Matlock42/SensoryBridge/extras/OSHW/PCB/SENSORY_BRIDGE_kicad6/SENSORY_BRIDGE_BOM.xlsx

Index | Quantity | Part Number | Manufacturer Part Number | Description | Customer Reference | Available | Backorder | Unit Price | Extended Price USD
1 | 1 | 796949-4-ND | 796949-4 | TERM BLK 4P SIDE ENT 5.08MM PCB | J2 | 1 | 0 | 2.93 | 2.93
2 | 1 | 1965-ESP32-S2-MINI-1-N4R2CT-ND | ESP32-S2-MINI-1-N4R2 | SMD MOD ESP32-S2FN4R2 PCB ANT | IC1 | 1 | 0 | 2.32 | 2.32
3 | 1 | 497-13420-1-ND | ECMF02-4CMX8 | CMC 2LN SMD ESD | U3 | 1 | 0 | 0.87 | 0.87
4 | 1 | AP7361-33E-13DICT-ND | AP7361-33E-13 | IC REG LINEAR 3.3V 1A SOT223 | U2 | 0 | 1 | 0.54 | 0.54
5 | 2 | CKN9104CT-ND | PTS525SM15SMTR2 LFS | SWITCH TACTILE SPST-NO 0.02A 15V | SW3 | 2 | 0 | 0.65 | 1.30
6 | 1 | 423-1405-1-ND | SPH0645LM4H-B | CRAWFORD MIC DGT I2S BOTTOM PORT | U1 | 1 | 0 | 3.18 | 3.18
7 | 1 | 2073-USB4110-GF-A-1-ND | USB4110-GF-A | CONN RCP USB2.0 TYP C 24P SMD RA | J1 | 1 | 0 | 1.35 | 1.35
8 | 3 | 3386P-103TLF-ND | 3386P-1-103TLF | TRIMMER 10K OHM 0.5W PC PIN TOP | R1, R2, R3 | 3 | 0 | 2.5 | 7.50
9 | 1 | S7109-ND | PPPC062LFBN-RC | CONN HDR 12POS 0.1 GOLD PCB | JP1 | 1 | 0 | 0.82 | 0.82
10 | 1 | BL-BGX3V1-ND | BL-BGX3V1 | LED GREEN CLEAR 3M T/H | LED2 | 1 | 0 | 0.27 | 0.27
11 | 2 | 732-5014-ND | 151033YS03000 | LED YELLOW CLEAR 3MM ROUND T/H | LED1, LED3 | 2 | 0 | 0.18 | 0.36
12 | 1 | RMCF0805JT30R0CT-ND | RMCF0805JT30R0 | RES 30 OHM 5% 1/8W 0805 | R5 | 1 | 0 | 0.1 | 0.10
13 | 3 | 738-RMCF0805FT66R5CT-ND | RMCF0805FT66R5 | RES 66.5 OHM 1% 1/8W 0805 | R4, R6 | 3 | 0 | 0.1 | 0.30
14 | 1 | YAG3758CT-ND | AC0805JR-0710KL | RES SMD 10K OHM 5% 1/8W 0805 | R7 | 1 | 0 | 0.1 | 0.10
15 | 2 | YAG3744CT-ND | AC0805FR-075K1L | RES SMD 5.1K OHM 1% 1/8W 0805 | R9 | 2 | 0 | 0.1 | 0.20
16 | 4 | 1276-1099-1-ND | CL21B104KACNNNC | CAP CER 0.1UF 25V X7R 0805 | C5 | 4 | 0 | 0.1 | 0.40
17 | 3 | 1276-1066-1-ND | CL21B105KAFNNNE | CAP CER 1UF 25V X7R 0805 | C1 | 3 | 0 | 0.1 | 0.30
18 | 2 | 399-C0805C200J5HAC7800CT-ND | C0805C200J5HAC7800 | CAP CER 20PF 50V X8R 0805 | C7 | 2 | 0 | 0.1 | 0.20
19 | 1 | 1276-6460-1-ND | CL21A226MQQNNNG | CAP CER 22UF 6.3V X5R 0805 | C4 | 1 | 0 | 0.13 | 0.13
20 | 1 | 1276-1244-1-ND | CL21A475KAQNNNE | CAP CER 4.7UF 25V X5R 0805 | C2 | 1 | 0 | 0.1 | 0.10
21 | 1 | AZ1117IH-3.3TRG1DICT-ND | AZ1117IH-3.3TRG1 | IC REG LINEAR 3.3V 1A SOT223 | U2 Alt (chng pins) | 1 | 0 | 0.4 | 0.40
22 | 2 | 2223-TS02-66-60-BK-160-LCR-D-ND | TS02-66-60-BK-160-LCR-D | 6 X 6 MM, 6 MM ACTUATOR HEIGHT, |  | 2 | 0 | 0.1 | 0.20
