Matlock42/SensoryBridge/extras/OSHW/PCB/SENSORY_BRIDGE_kicad6/SENSORY_BRIDGE.kicad_pcb

## KiCad design extras/OSHW/PCB/SENSORY_BRIDGE_kicad6/SENSORY_BRIDGE.kicad_pcb (2022-09-30)

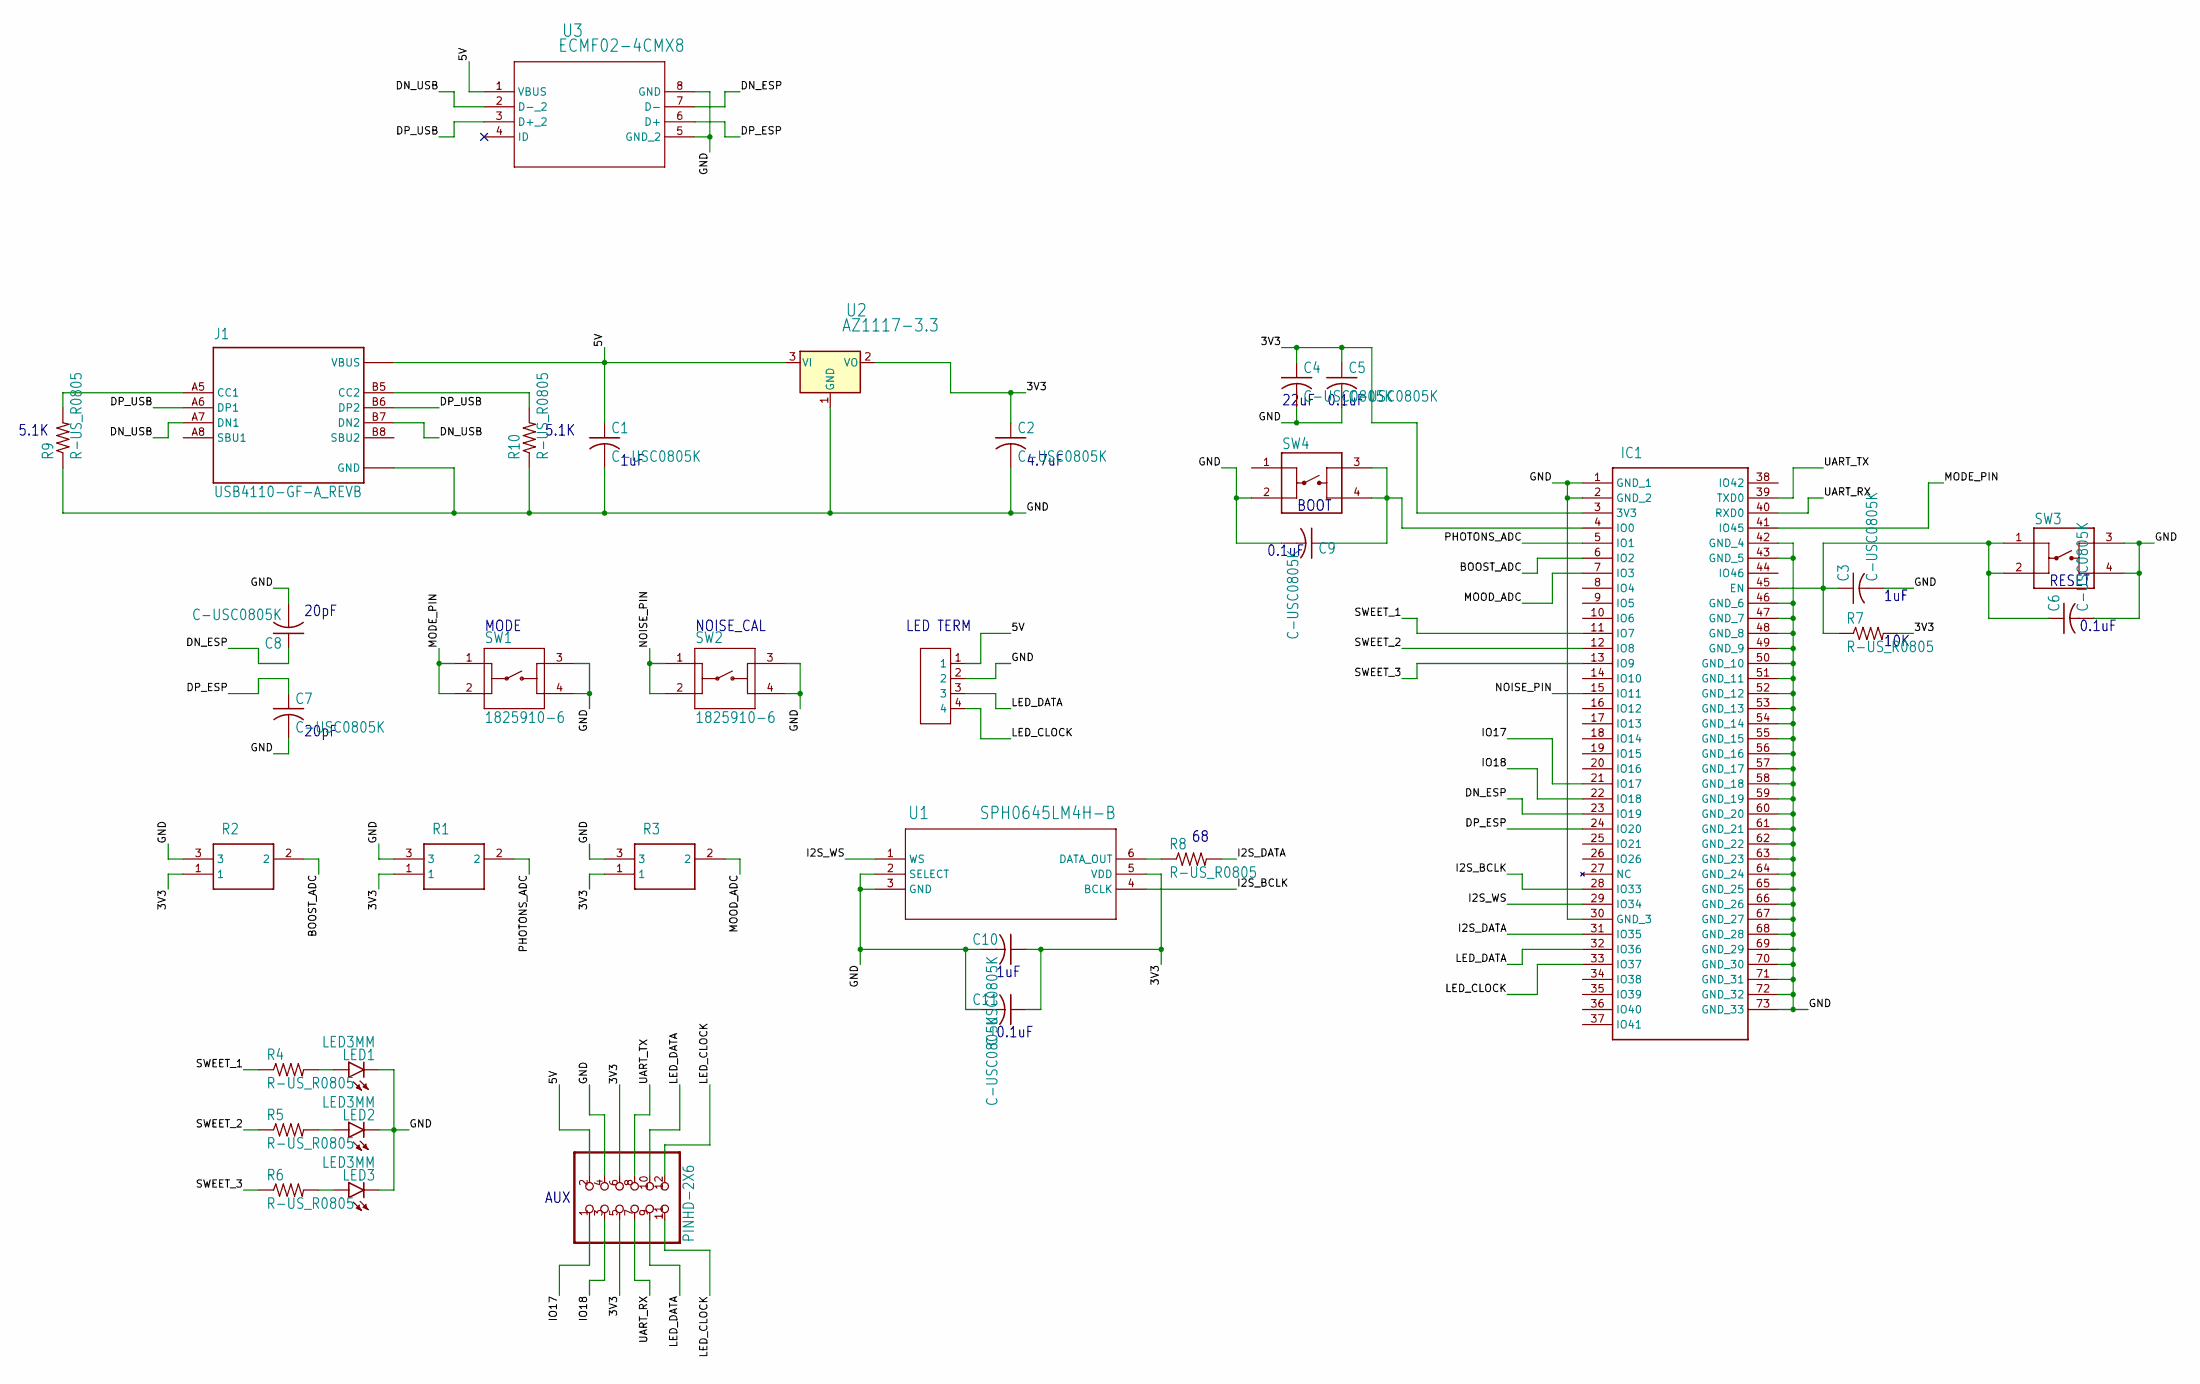
[picture p1: schematic SENSORY_BRIDGE.kicad_sch]

Parts:
C1, C2, C3, C4, C5, C6, C7, C8, C9, C10, C11: C-USC0805K; C0805K
IC1: ESP32-S2-MINI-1-N4R2; ESP32S2MINI1N4R2
J1: USB4110-GF-A_REVB; GCT_USB4110-GF-A_REVB
J2: 796949-4; TE_796949-4
JP1: PINHD-2X6; 2X06
LED1, LED2, LED3: LED3MM
R1, R2, R3: 3386P-1-103LF; 3386P_1
R4, R5, R6, R7, R8, R9, R10: R-US_R0805; R0805
SW1, SW2: 1825910-6; SW_1825910-6-4
SW3, SW4: PTS525SM15SMTR2LFS; SW_PTS525SM15SMTR2LFS
U1: SPH0645LM4H-B; SPH0645LM4H-B_KNO
U2: AZ1117-3.3; SOT-223_DIO-M
U3: ECMF02-4CMX8; MICRO_QFN-8L_STM

Connections:
/3V3: C2.1, C4.1, C5.1, C10.1, C11.1, IC1.3 (3V3), JP1.5, JP1.6, R1.1, R2.1, R3.1, R7.2, U1.5 (VDD), U2.2 (VO)
/5V: C1.1, J1.A4/B9 (VBUS), J1.B4/A9 (VBUS), J2.1, JP1.2, U2.3 (VI), U3.1 (VBUS)
/BOOST_ADC: IC1.6 (IO2), R2.2
/DN_ESP: C8.1, IC1.23 (IO19), U3.7 (D-)
/DN_USB: J1.A7 (DN1), J1.B7 (DN2), U3.2 (D-_2)
/DP_ESP: C7.1, IC1.24 (IO20), U3.6 (D+)
/DP_USB: J1.A6 (DP1), J1.B6 (DP2), U3.3 (D+_2)
/GND: C1.2, C2.2, C3.2, C4.2, C5.2, C6.2, C7.2, C8.2, C9.2, C10.2, C11.2, IC1.1 (GND_1), IC1.2 (GND_2), IC1.30 (GND_3), IC1.42 (GND_4), IC1.43 (GND_5), IC1.46 (GND_6), IC1.47 (GND_7), IC1.48 (GND_8), IC1.49 (GND_9), IC1.50 (GND_10), IC1.51 (GND_11), IC1.52 (GND_12), IC1.53 (GND_13), IC1.54 (GND_14), IC1.55 (GND_15), IC1.56 (GND_16), IC1.57 (GND_17), IC1.58 (GND_18), IC1.59 (GND_19), IC1.60 (GND_20), IC1.61 (GND_21), IC1.62 (GND_22), IC1.63 (GND_23), IC1.64 (GND_24), IC1.65 (GND_25), IC1.66 (GND_26), IC1.67 (GND_27), IC1.68 (GND_28), IC1.69 (GND_29), IC1.70 (GND_30), IC1.71 (GND_31), IC1.72 (GND_32), IC1.73 (GND_33), J1.A1/B12 (GND), J1.B1/A12 (GND), J1.S1 (GND), J1.S2 (GND), J1.S3 (GND), J1.S4 (GND), J2.2, JP1.4, LED1.K (C), LED2.K (C), LED3.K (C), R1.3, R2.3, R3.3, R9.1, R10.1, SW1.3, SW1.4, SW2.3, SW2.4, SW3.3, SW3.4, SW4.2, U1.2 (SELECT), U1.3 (GND), U2.1 (GND), U3.5 (GND_2), U3.8 (GND)
/I2S_BCLK: IC1.28 (IO33), U1.4 (BCLK)
/I2S_DATA: IC1.31 (IO35), R8.2
/I2S_WS: IC1.29 (IO34), U1.1 (WS)
/IO17: IC1.21 (IO17), JP1.1
/IO18: IC1.22 (IO18), JP1.3
/LED_CLOCK: IC1.33 (IO37), J2.4, JP1.11, JP1.12
/LED_DATA: IC1.32 (IO36), J2.3, JP1.9, JP1.10
/MODE_PIN: IC1.41 (IO45), SW1.1, SW1.2
/MOOD_ADC: IC1.7 (IO3), R3.2
/NOISE_PIN: IC1.15 (IO11), SW2.1, SW2.2
/PHOTONS_ADC: IC1.5 (IO1), R1.2
/SWEET_1: IC1.11 (IO7), R4.1
/SWEET_2: IC1.12 (IO8), R5.1
/SWEET_3: IC1.13 (IO9), R6.1
/UART_RX: IC1.40 (RXD0), JP1.7
/UART_TX: IC1.39 (TXD0), JP1.8
unnamed: C3.1, C6.1, IC1.45 (EN), R7.1, SW3.1, SW3.2
unnamed: C9.1, IC1.4 (IO0), SW4.3, SW4.4
unnamed: J1.A5 (CC1), R9.2
unnamed: J1.B5 (CC2), R10.2
unnamed: LED1.A, R4.2
unnamed: LED2.A, R5.2
unnamed: LED3.A, R6.2
unnamed: R8.1, U1.6 (DATA_OUT)

Notes on the sheet:
1uF
5.1K
MODE
RESET
BOOT
4.7uF
0.1uF
22uF
AUX
20pF
LED TERM
10K
NOISE_CAL

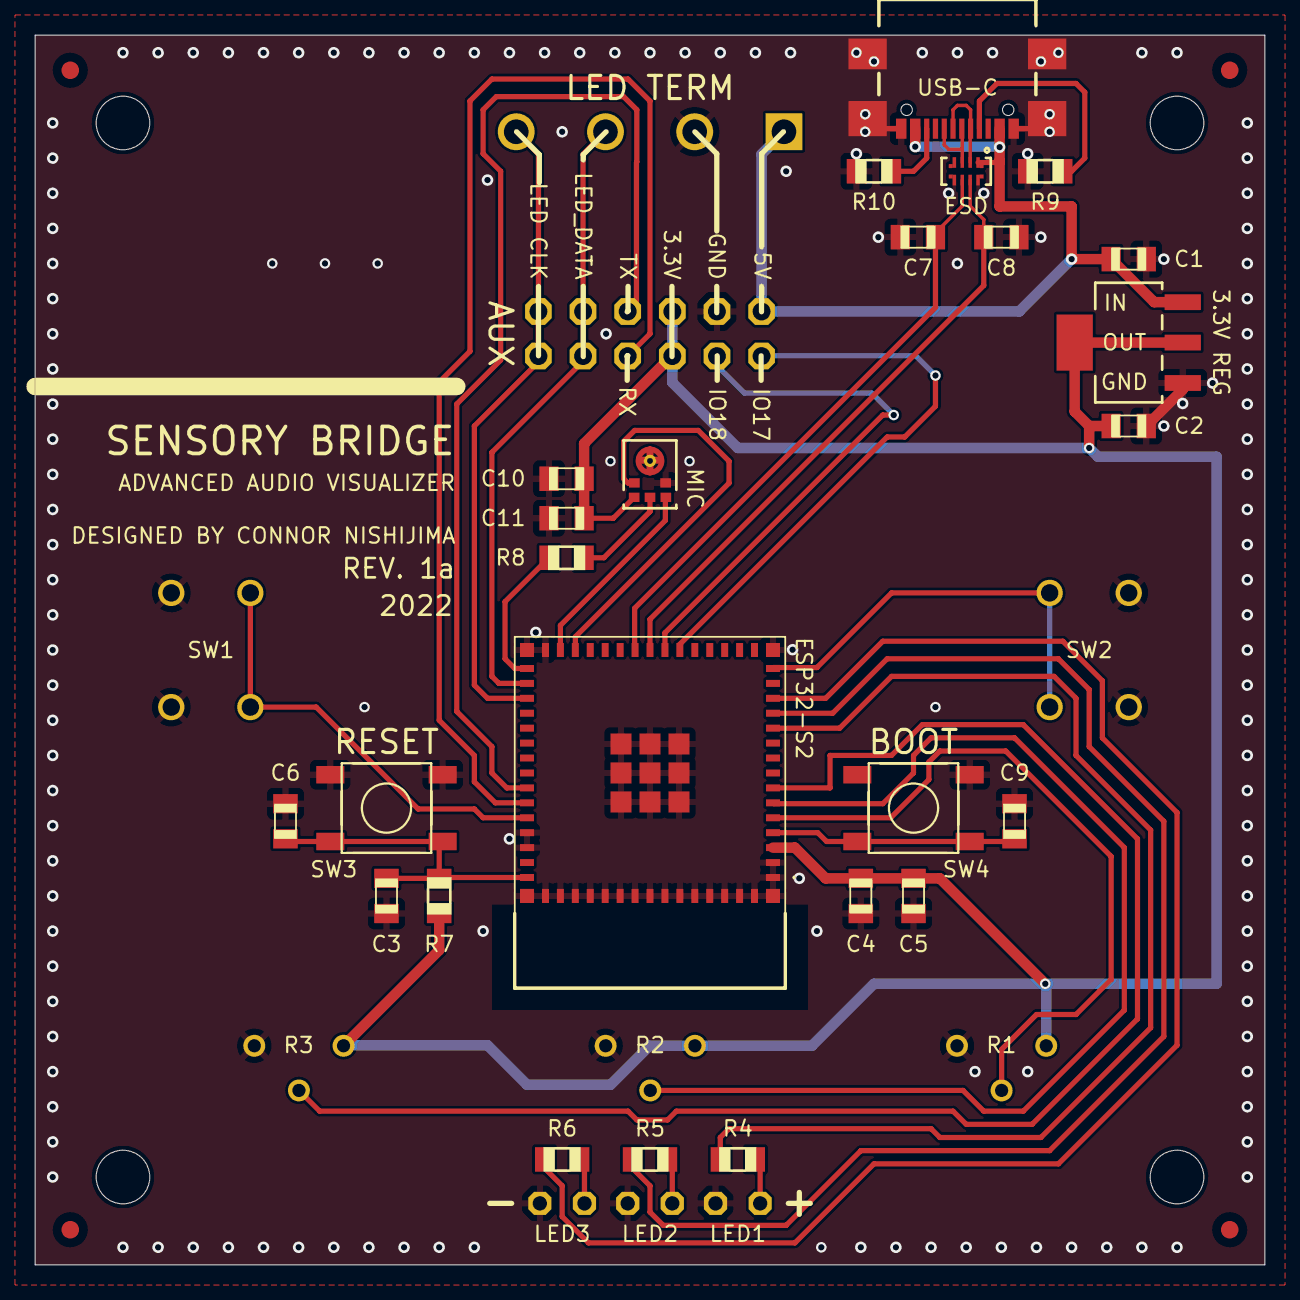
[picture p2: board SENSORY_BRIDGE.kicad_pcb from above]

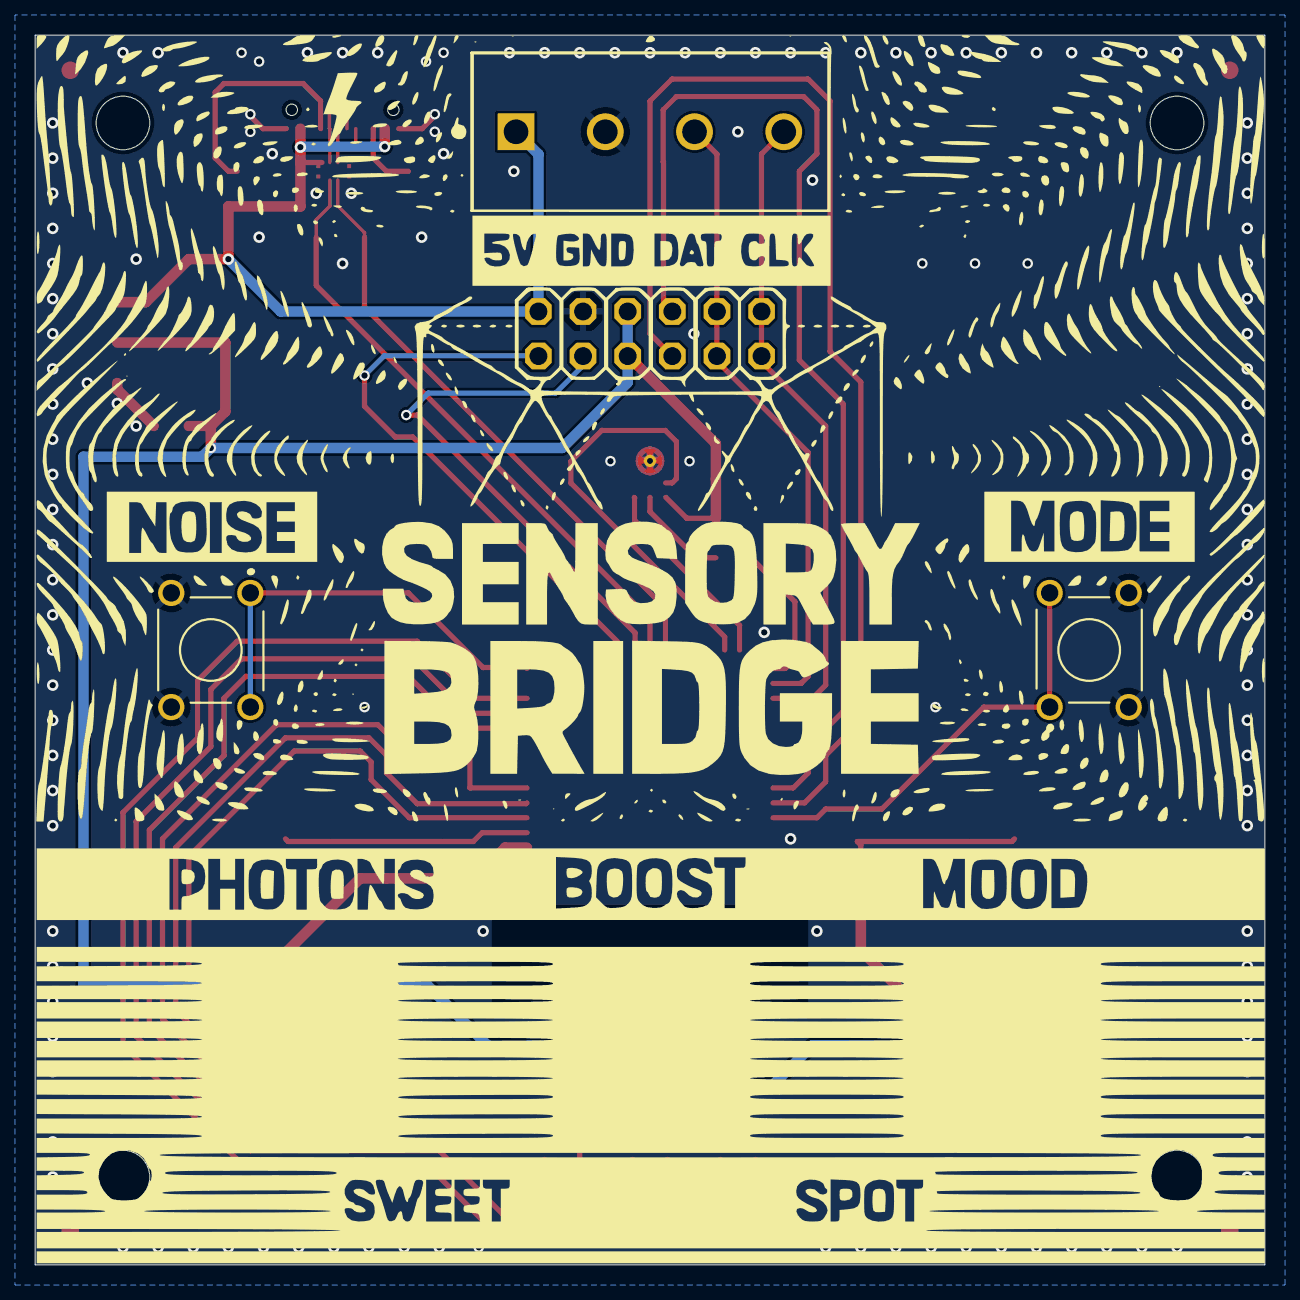
[picture p3: board SENSORY_BRIDGE.kicad_pcb from below]

Board: 2 copper layers, 70.0 x 70.0 mm, 43 parts (10 on the bottom side), 32 nets.

Other parts of the board:
@HOLE0, @HOLE1, @HOLE2, @HOLE3: (no value)
U$1, U$2, U$3, U$4: CIRCLE-1MM-2R
