Matlock42/SensoryBridge/SENSORY_BRIDGE_FIRMWARE/constants.h

#define SAMPLE_RATE  18750
#define BUFFER_SIZE  256
#define I2S_PORT     I2S_NUM_0

#define FFT_HISTORY_LEN            6
#define AMBIENT_NOISE_SAMPLES      10

#define SWEET_SPOT   0.45F

#define PHOTONS_PIN  1
#define BOOST_PIN    2
#define MOOD_PIN     3

#define SWEET_SPOT_LEFT_PIN    7
#define SWEET_SPOT_CENTER_PIN  13
#define SWEET_SPOT_RIGHT_PIN   9

#define NOISE_CAL_PIN  4
#define MODE_PIN       5

#define NUM_LEDS       10
#define LED_DATA_PIN   8
#define LED_CLOCK_PIN  37

#define I2S_BCLK_PIN   33
#define I2S_LRCLK_PIN  34
#define I2S_DOUT_PIN   24
