Matlock42/SensoryBridge/(commit log)

2022-09-29 Change regulator layout to accept AZ1117IH-3.3TRG1 and similar voltage regulator
    I haven't worked with Eagle so I converted design to KiCad for these changes. The graphics didn't export/import well so I generated the gerber files (1a) and overwrote the back silkscreen with the original artwork.
    [SENSORY_BRIDGE-B_Cu.gbr, SENSORY_BRIDGE-B_Mask.gbr, SENSORY_BRIDGE-B_Paste.gbr, SENSORY_BRIDGE-B_Silkscreen.gbr, SENSORY_BRIDGE-Edge_Cuts.gbr, SENSORY_BRIDGE-F_Cu.gbr, SENSORY_BRIDGE-F_Mask.gbr, SENSORY_BRIDGE-F_Paste.gbr]
2022-09-30 Fixed pads for mems microphone and mounting holes
    Also added BOM
    [SENSORY_BRIDGE-B_Cu.gbr, SENSORY_BRIDGE-B_Mask.gbr, SENSORY_BRIDGE-B_Paste.gbr, SENSORY_BRIDGE-Edge_Cuts.gbr, SENSORY_BRIDGE-F_Cu.gbr, SENSORY_BRIDGE-F_Mask.gbr, SENSORY_BRIDGE-F_Paste.gbr, SENSORY_BRIDGE-F_Silkscreen.gbr]
2022-10-02 Port SensoryBridge to CircuitPlayground
    Adafruit CircuitPlayground has most of the necessary hardware to replicate the functionality already on board. However, LittleFS doesn't appear to be supported on the Nordic nRF52840. This is not a huge deal to me if the settings are not saved.
    [configuration.h]
